CHALAK-04/bookfinder-robot/results/shelf_captures/row_1.jpg

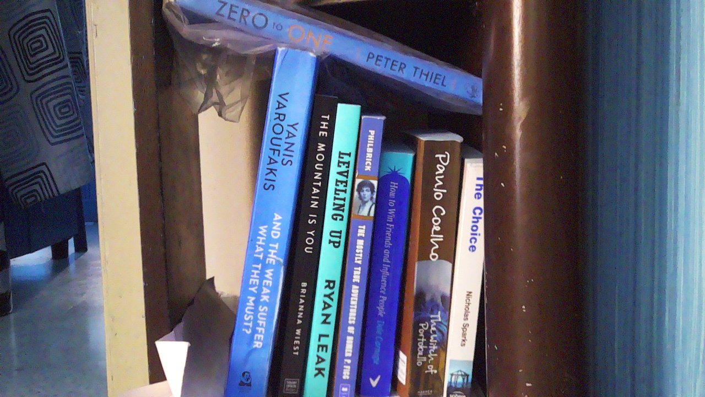
results/shelf_captures/row_1.jpg
