CHALAK-04/bookfinder-robot/results/shelf_captures/row_2.jpg

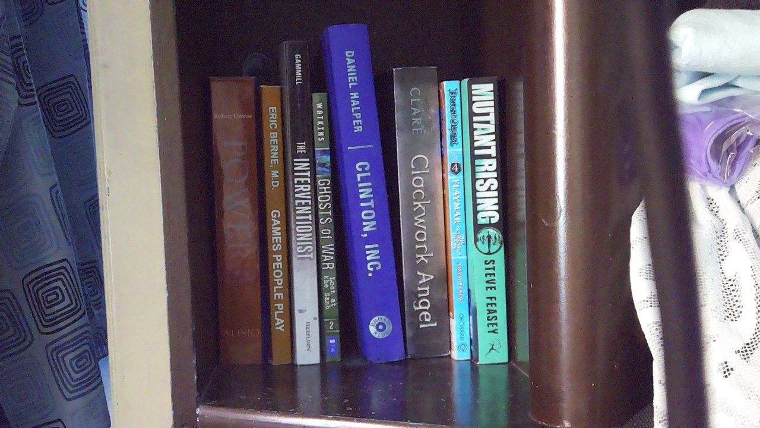
results/shelf_captures/row_2.jpg
