CHALAK-04/bookfinder-robot/results/shelf_captures/row_3.jpg

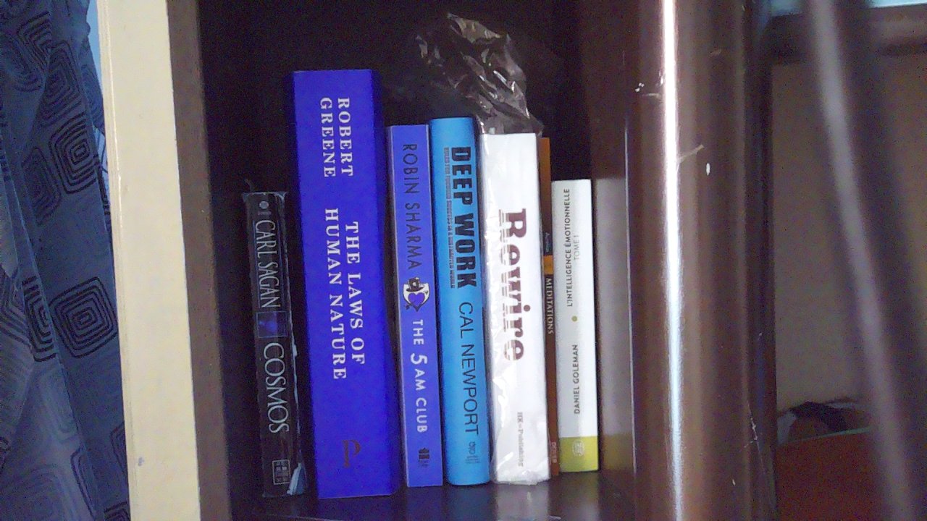
results/shelf_captures/row_3.jpg
